tianitn333/QRS_FPGA_Code/docs/THIRD_PARTY.md

# 第三方来源

CAN控制器使用OpenCores CAN RTL，来源与版权见project/user_source/hdl_source/can/README.txt及各源文件头，保留LGPL相关声明；资源试验所固定上游提交为470f0e7ab174dfef01a05f5d5ad01f28f6f4dc17。

PLL、DDR、FIFO、MIPI/HDMI等包含安路及相关厂商生成或加密的IP源/元数据，保留原文件及版权头，需要匹配TD器件库/工具解释；本包不将第三方IP描述为参赛者原创，也不附工具安装包。源文件中的历史模块可作为依赖和完整源码保留，当前工程实际生效文件以AL为准，SD颜色持久化未在当前顶层启用。
