tianitn333/QRS_FPGA_Code/verification/board_success/README.md

# 用户成功段CAN记录核对

以CSV序号2074～3580为有效段，共1507条；2073只作为首个46请求的边界上下文。原始物理文件行号另存，避免表头偏移。原文件前2073条及诊断心跳不计作本次成功段。

共匹配746个完整请求/应答事务，包含3次双轴初始化、16条绝对位置命令（6条展示、10条零位），未见未配对应答或E2/EE拒绝。

| 请求序号 | 时间 | 地址 | 绝对目标 | 最后编码器 | 位置应答序号 | 最后状态 | 状态应答序号 |
| --- | --- | --- | ---: | ---: | --- | --- | --- |
| 2103 | 11:14:18:346 | 1 | 0 | 5 | 2109 | 3A 83 6B | 2111 |
| 2114 | 11:14:18:407 | 2 | 0 | -7 | 2120 | 3A 83 6B | 2122 |
| 2125 | 11:14:28:962 | 1 | -4047 | -82949 | 2313 | 3A 83 6B | 2315 |
| 2318 | 11:14:30:894 | 2 | -1727 | -35479 | 2420 | 3A 83 6B | 2422 |
| 2461 | 11:15:35:338 | 1 | 0 | -9 | 2467 | 3A 83 6B | 2469 |
| 2472 | 11:15:35:402 | 2 | 0 | -5 | 2478 | 3A 83 6B | 2480 |
| 2483 | 11:15:47:136 | 1 | -1727 | -35487 | 2621 | 3A 83 6B | 2623 |
| 2626 | 11:15:48:574 | 2 | -2817 | -57791 | 2818 | 3A 83 6B | 2820 |
| 2861 | 11:16:58:249 | 1 | 0 | -9 | 2867 | 3A 83 6B | 2869 |
| 2872 | 11:16:58:312 | 2 | 0 | -5 | 2878 | 3A 83 6B | 2880 |
| 2883 | 11:17:50:273 | 1 | 0 | -7 | 2889 | 3A 83 6B | 2891 |
| 2894 | 11:17:50:334 | 2 | 0 | -3 | 2900 | 3A 83 6B | 2902 |
| 2905 | 11:18:02:658 | 1 | -4047 | -82995 | 3143 | 3A 83 6B | 3145 |
| 3148 | 11:18:05:150 | 2 | -1727 | -35493 | 3282 | 3A 83 6B | 3284 |
| 3287 | 11:22:49:769 | 1 | 0 | 43 | 3473 | 3A 83 6B | 3475 |
| 3478 | 11:22:51:642 | 2 | 0 | -7 | 3578 | 3A 83 6B | 3580 |

所有位置命令均50RPM、绝对模式01、同步00；各次位置最终在对应±128计数容差内，随后状态为3A83。最后一次双轴回零请求序号3287/3478，编码器+43/-7，状态应答3475/3580。

主机时间戳大量重复，不能据此验证精确20ms等待或5ms分片间隔。记录中的FE/F3停止失能可能来自SW2操作等，不能仅凭这些命令认定FPGA故障。协议闭环通过不自动扩展成机械安全或长期稳定全部通过。
