tianitn333/QRS_FPGA_Code/verification/board_success/user_success_original.csv

序号 | 传输方向 | 时间标识-1 | 名称 | 帧ID(靠右对齐) | 帧格式 | 帧类型 | 数据长度 | 数据(HEX)
0 | 接收 | 10:05:37:834 |  | 0x00000100 | 数据帧 | 扩展帧 | 5 | 46 69 00 01 6B
1 | 接收 | 10:05:37:834 |  | 0x00000100 | 数据帧 | 扩展帧 | 3 | 46 02 6B
2 | 接收 | 10:05:37:834 |  | 0x00000100 | 数据帧 | 扩展帧 | 3 | 0A 6D 6B
3 | 接收 | 10:05:38:333 |  | 0x00000100 | 数据帧 | 扩展帧 | 4 | FE 98 00 6B
4 | 接收 | 10:05:38:333 |  | 0x00000100 | 数据帧 | 扩展帧 | 3 | FE 02 6B
5 | 接收 | 10:05:38:333 |  | 0x00000100 | 数据帧 | 扩展帧 | 5 | F3 AB 00 00 6B
6 | 接收 | 10:05:38:333 |  | 0x00000100 | 数据帧 | 扩展帧 | 3 | F3 02 6B
7 | 接收 | 10:05:38:333 |  | 0x00000200 | 数据帧 | 扩展帧 | 4 | FE 98 00 6B
8 | 接收 | 10:05:38:333 |  | 0x00000200 | 数据帧 | 扩展帧 | 3 | FE E2 6B
9 | 接收 | 10:05:38:333 |  | 0x00000200 | 数据帧 | 扩展帧 | 5 | F3 AB 00 00 6B
10 | 接收 | 10:05:38:333 |  | 0x00000200 | 数据帧 | 扩展帧 | 3 | F3 02 6B
11 | 接收 | 10:48:52:763 |  | 0x000007e0 | 数据帧 | 扩展帧 | 8 | 08 00 00 00 00 00 00 00
12 | 接收 | 10:48:52:763 |  | 0x000007e1 | 数据帧 | 扩展帧 | 8 | 00 00 00 00 00 00 00 00
13 | 接收 | 10:48:52:763 |  | 0x000007e0 | 数据帧 | 扩展帧 | 8 | 08 01 00 00 10 00 00 00
14 | 接收 | 10:48:52:763 |  | 0x000007e1 | 数据帧 | 扩展帧 | 8 | 00 00 00 00 00 00 00 00
15 | 接收 | 10:48:53:762 |  | 0x000007e0 | 数据帧 | 扩展帧 | 8 | 10 02 00 00 10 00 00 00
16 | 接收 | 10:48:53:762 |  | 0x000007e1 | 数据帧 | 扩展帧 | 8 | D7 00 00 00 00 00 00 00
17 | 接收 | 10:48:54:755 |  | 0x000007e0 | 数据帧 | 扩展帧 | 8 | 10 03 00 00 10 00 00 00
18 | 接收 | 10:48:54:755 |  | 0x000007e1 | 数据帧 | 扩展帧 | 8 | D7 00 00 00 00 00 00 00
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
1456 | 接收 | 11:00:53:764 |  | 0x000007e1 | 数据帧 | 扩展帧 | 8 | D7 00 00 00 00 00 00 00
1457 | 接收 | 11:00:54:766 |  | 0x000007e0 | 数据帧 | 扩展帧 | 8 | 10 D3 00 00 10 00 00 00
1458 | 接收 | 11:00:54:766 |  | 0x000007e1 | 数据帧 | 扩展帧 | 8 | D7 00 00 00 00 00 00 00
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
