tianitn333/QRS_FPGA_Code/project/user_source/hdl_source/anlogic_logo_palette.v

// Exact official Logo pixels: common colors plus tagged sparse read-only data.
// 官方Logo无损像素：常用色组合译码，其余颜色使用带标签的只读ERAM。
// One-clock read; the caller must present the previous pixel-stage address.
module anlogic_logo_palette (
    input wire clk,
    input wire rst_n,
    input wire [14:0] I_addr,
    output reg [24:0] O_pixel
);
    reg [11:0] displacement;
    wire [11:0] memory_address;
    wire [143:0] memory_data;
    wire [35:0] selected_data;
    reg [1:0] read_bank;
    reg [14:0] read_address;
    reg read_valid;
    reg [1:0] base_color;

    // The bucket and displacement retain all original address information.
    always @(*) begin
        displacement = 12'd0;
        case (I_addr[8:0])
            9'd0: displacement = 12'd335;
            9'd1: displacement = 12'd804;
            9'd2: displacement = 12'd832;
            9'd3: displacement = 12'd288;
            9'd4: displacement = 12'd834;
            9'd5: displacement = 12'd806;
            9'd6: displacement = 12'd840;
            9'd7: displacement = 12'd612;
            9'd8: displacement = 12'd851;
            9'd9: displacement = 12'd161;
            9'd10: displacement = 12'd842;
            9'd11: displacement = 12'd1361;
            9'd12: displacement = 12'd1648;
            9'd13: displacement = 12'd294;
            9'd14: displacement = 12'd620;
            9'd15: displacement = 12'd1664;
            9'd16: displacement = 12'd872;
            9'd17: displacement = 12'd866;
            9'd18: displacement = 12'd1442;
            9'd19: displacement = 12'd2209;
            9'd20: displacement = 12'd2364;
            9'd21: displacement = 12'd1665;
            9'd22: displacement = 12'd1342;
            9'd23: displacement = 12'd1336;
            9'd24: displacement = 12'd1317;
            9'd25: displacement = 12'd1666;
            9'd26: displacement = 12'd987;
            9'd27: displacement = 12'd785;
            9'd28: displacement = 12'd1586;
            9'd29: displacement = 12'd1672;
            9'd30: displacement = 12'd246;
            9'd31: displacement = 12'd1193;
            9'd32: displacement = 12'd932;
            9'd33: displacement = 12'd2067;
            9'd34: displacement = 12'd2368;
            9'd35: displacement = 12'd2369;
            9'd36: displacement = 12'd1572;
            9'd37: displacement = 12'd1717;
            9'd38: displacement = 12'd2370;
            9'd39: displacement = 12'd1667;
            9'd40: displacement = 12'd1142;
            9'd41: displacement = 12'd1043;
            9'd42: displacement = 12'd1201;
            9'd43: displacement = 12'd1255;
            9'd44: displacement = 12'd1697;
            9'd45: displacement = 12'd2371;
            9'd46: displacement = 12'd2036;
            9'd47: displacement = 12'd1398;
            9'd48: displacement = 12'd510;
            9'd49: displacement = 12'd2204;
            9'd50: displacement = 12'd2380;
            9'd51: displacement = 12'd1658;
            9'd52: displacement = 12'd1698;
            9'd53: displacement = 12'd1728;
            9'd54: displacement = 12'd896;
            9'd55: displacement = 12'd417;
            9'd56: displacement = 12'd751;
            9'd57: displacement = 12'd897;
            9'd58: displacement = 12'd2382;
            9'd59: displacement = 12'd1729;
            9'd60: displacement = 12'd308;
            9'd61: displacement = 12'd1534;
            9'd62: displacement = 12'd1713;
            9'd63: displacement = 12'd1730;
            9'd64: displacement = 12'd904;
            9'd65: displacement = 12'd928;
            9'd66: displacement = 12'd1678;
            9'd67: displacement = 12'd929;
            9'd68: displacement = 12'd320;
            9'd69: displacement = 12'd66;
            9'd70: displacement = 12'd938;
            9'd71: displacement = 12'd1731;
            9'd72: displacement = 12'd821;
            9'd73: displacement = 12'd34;
            9'd74: displacement = 12'd323;
            9'd75: displacement = 12'd917;
            9'd76: displacement = 12'd322;
            9'd77: displacement = 12'd352;
            9'd78: displacement = 12'd960;
            9'd79: displacement = 12'd1736;
            9'd80: displacement = 12'd961;
            9'd81: displacement = 12'd1737;
            9'd82: displacement = 12'd968;
            9'd83: displacement = 12'd969;
            9'd84: displacement = 12'd1761;
            9'd85: displacement = 12'd992;
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
            9'd510: displacement = 12'd781;
            9'd511: displacement = 12'd800;
            default: displacement = 12'd0;
        endcase
    end
    assign memory_address = displacement ^ {6'd0, I_addr[14:9]};
    assign selected_data = memory_data[read_bank*36 +: 36];

    // Match the synchronous ERAM port with its bucket tag and bank selection.
    always @(posedge clk or negedge rst_n) begin
        if (!rst_n) begin
            read_bank <= 2'd0;
            read_address <= 15'd0;
            read_valid <= 1'b0;
        end else begin
            read_bank <= memory_address[11:10];
            read_address <= I_addr;
            read_valid <= 1'b1;
        end
    end

    // Initialized 18x1024 word bank, read-only during video operation.
    PH1P_LOGIC_ERAM #(
        .DATA_WIDTH_A(18), .DATA_WIDTH_B(18), .ADDR_WIDTH_A(10), .ADDR_WIDTH_B(10),
        .DATA_DEPTH_A(1024), .DATA_DEPTH_B(1024), .MODE("DP"),
        .REGMODE_A("NOREG"), .REGMODE_B("NOREG"), .WRITEMODE_A("NORMAL"), .WRITEMODE_B("NORMAL"),
        .IMPLEMENT("20K(FAST)"), .ECC_ENCODE("DISABLE"), .ECC_DECODE("DISABLE"),
        .CLKMODE("ASYNC"), .SSROVERCE("DISABLE"), .OREGSET_A("RESET"), .OREGSET_B("RESET"),
        .RESETMODE_A("ASYNC"), .RESETMODE_B("ASYNC"),
        .ASYNC_RESET_RELEASE_A("ASYNC"), .ASYNC_RESET_RELEASE_B("ASYNC"),
        .INIT_FILE("logo_palette_data/bank_0_lane_0.dath"), .FILL_ALL("NONE")
    ) PH1P_LOGIC_ERAM_Inst_first_low (
        .dia(18'd0), .addra(10'd0), .cea(1'b0), .clka(clk), .wea(1'b0), .bea(1'b0), .rsta(1'b0), .ocea(1'b0),
        .dib(18'd0), .addrb(memory_address[9:0]), .ceb(1'b1), .clkb(clk), .web(1'b0), .beb(1'b0), .rstb(1'b0), .oceb(1'b0),
        .doa(), .dob(memory_data[17:0]),
        .ecc_sbiterr(), .ecc_dbiterr(), .ecc_sbiterrinj(1'b0), .ecc_dbiterrinj(1'b0)
    );

    // Initialized 18x1024 word bank, read-only during video operation.
    PH1P_LOGIC_ERAM #(
        .DATA_WIDTH_A(18), .DATA_WIDTH_B(18), .ADDR_WIDTH_A(10), .ADDR_WIDTH_B(10),
        .DATA_DEPTH_A(1024), .DATA_DEPTH_B(1024), .MODE("DP"),
        .REGMODE_A("NOREG"), .REGMODE_B("NOREG"), .WRITEMODE_A("NORMAL"), .WRITEMODE_B("NORMAL"),
        .IMPLEMENT("20K(FAST)"), .ECC_ENCODE("DISABLE"), .ECC_DECODE("DISABLE"),
        .CLKMODE("ASYNC"), .SSROVERCE("DISABLE"), .OREGSET_A("RESET"), .OREGSET_B("RESET"),
        .RESETMODE_A("ASYNC"), .RESETMODE_B("ASYNC"),
        .ASYNC_RESET_RELEASE_A("ASYNC"), .ASYNC_RESET_RELEASE_B("ASYNC"),
        .INIT_FILE("logo_palette_data/bank_0_lane_1.dath"), .FILL_ALL("NONE")
    ) PH1P_LOGIC_ERAM_Inst_first_high (
        .dia(18'd0), .addra(10'd0), .cea(1'b0), .clka(clk), .wea(1'b0), .bea(1'b0), .rsta(1'b0), .ocea(1'b0),
        .dib(18'd0), .addrb(memory_address[9:0]), .ceb(1'b1), .clkb(clk), .web(1'b0), .beb(1'b0), .rstb(1'b0), .oceb(1'b0),
        .doa(), .dob(memory_data[35:18]),
        .ecc_sbiterr(), .ecc_dbiterr(), .ecc_sbiterrinj(1'b0), .ecc_dbiterrinj(1'b0)
    );

    // Initialized 18x1024 word bank, read-only during video operation.
    PH1P_LOGIC_ERAM #(
        .DATA_WIDTH_A(18), .DATA_WIDTH_B(18), .ADDR_WIDTH_A(10), .ADDR_WIDTH_B(10),
        .DATA_DEPTH_A(1024), .DATA_DEPTH_B(1024), .MODE("DP"),
        .REGMODE_A("NOREG"), .REGMODE_B("NOREG"), .WRITEMODE_A("NORMAL"), .WRITEMODE_B("NORMAL"),
        .IMPLEMENT("20K(FAST)"), .ECC_ENCODE("DISABLE"), .ECC_DECODE("DISABLE"),
        .CLKMODE("ASYNC"), .SSROVERCE("DISABLE"), .OREGSET_A("RESET"), .OREGSET_B("RESET"),
        .RESETMODE_A("ASYNC"), .RESETMODE_B("ASYNC"),
        .ASYNC_RESET_RELEASE_A("ASYNC"), .ASYNC_RESET_RELEASE_B("ASYNC"),
        .INIT_FILE("logo_palette_data/bank_1_lane_0.dath"), .FILL_ALL("NONE")
    ) PH1P_LOGIC_ERAM_Inst_second_low (
        .dia(18'd0), .addra(10'd0), .cea(1'b0), .clka(clk), .wea(1'b0), .bea(1'b0), .rsta(1'b0), .ocea(1'b0),
        .dib(18'd0), .addrb(memory_address[9:0]), .ceb(1'b1), .clkb(clk), .web(1'b0), .beb(1'b0), .rstb(1'b0), .oceb(1'b0),
        .doa(), .dob(memory_data[53:36]),
        .ecc_sbiterr(), .ecc_dbiterr(), .ecc_sbiterrinj(1'b0), .ecc_dbiterrinj(1'b0)
    );

    // Initialized 18x1024 word bank, read-only during video operation.
    PH1P_LOGIC_ERAM #(
        .DATA_WIDTH_A(18), .DATA_WIDTH_B(18), .ADDR_WIDTH_A(10), .ADDR_WIDTH_B(10),
        .DATA_DEPTH_A(1024), .DATA_DEPTH_B(1024), .MODE("DP"),
        .REGMODE_A("NOREG"), .REGMODE_B("NOREG"), .WRITEMODE_A("NORMAL"), .WRITEMODE_B("NORMAL"),
        .IMPLEMENT("20K(FAST)"), .ECC_ENCODE("DISABLE"), .ECC_DECODE("DISABLE"),
        .CLKMODE("ASYNC"), .SSROVERCE("DISABLE"), .OREGSET_A("RESET"), .OREGSET_B("RESET"),
        .RESETMODE_A("ASYNC"), .RESETMODE_B("ASYNC"),
        .ASYNC_RESET_RELEASE_A("ASYNC"), .ASYNC_RESET_RELEASE_B("ASYNC"),
        .INIT_FILE("logo_palette_data/bank_1_lane_1.dath"), .FILL_ALL("NONE")
    ) PH1P_LOGIC_ERAM_Inst_second_high (
        .dia(18'd0), .addra(10'd0), .cea(1'b0), .clka(clk), .wea(1'b0), .bea(1'b0), .rsta(1'b0), .ocea(1'b0),
        .dib(18'd0), .addrb(memory_address[9:0]), .ceb(1'b1), .clkb(clk), .web(1'b0), .beb(1'b0), .rstb(1'b0), .oceb(1'b0),
        .doa(), .dob(memory_data[71:54]),
        .ecc_sbiterr(), .ecc_dbiterr(), .ecc_sbiterrinj(1'b0), .ecc_dbiterrinj(1'b0)
    );

    // Initialized 18x1024 word bank, read-only during video operation.
    PH1P_LOGIC_ERAM #(
        .DATA_WIDTH_A(18), .DATA_WIDTH_B(18), .ADDR_WIDTH_A(10), .ADDR_WIDTH_B(10),
        .DATA_DEPTH_A(1024), .DATA_DEPTH_B(1024), .MODE("DP"),
        .REGMODE_A("NOREG"), .REGMODE_B("NOREG"), .WRITEMODE_A("NORMAL"), .WRITEMODE_B("NORMAL"),
        .IMPLEMENT("20K(FAST)"), .ECC_ENCODE("DISABLE"), .ECC_DECODE("DISABLE"),
        .CLKMODE("ASYNC"), .SSROVERCE("DISABLE"), .OREGSET_A("RESET"), .OREGSET_B("RESET"),
        .RESETMODE_A("ASYNC"), .RESETMODE_B("ASYNC"),
        .ASYNC_RESET_RELEASE_A("ASYNC"), .ASYNC_RESET_RELEASE_B("ASYNC"),
        .INIT_FILE("logo_palette_data/bank_2_lane_0.dath"), .FILL_ALL("NONE")
    ) PH1P_LOGIC_ERAM_Inst_third_low (
        .dia(18'd0), .addra(10'd0), .cea(1'b0), .clka(clk), .wea(1'b0), .bea(1'b0), .rsta(1'b0), .ocea(1'b0),
        .dib(18'd0), .addrb(memory_address[9:0]), .ceb(1'b1), .clkb(clk), .web(1'b0), .beb(1'b0), .rstb(1'b0), .oceb(1'b0),
        .doa(), .dob(memory_data[89:72]),
        .ecc_sbiterr(), .ecc_dbiterr(), .ecc_sbiterrinj(1'b0), .ecc_dbiterrinj(1'b0)
    );

    // Initialized 18x1024 word bank, read-only during video operation.
    PH1P_LOGIC_ERAM #(
        .DATA_WIDTH_A(18), .DATA_WIDTH_B(18), .ADDR_WIDTH_A(10), .ADDR_WIDTH_B(10),
        .DATA_DEPTH_A(1024), .DATA_DEPTH_B(1024), .MODE("DP"),
        .REGMODE_A("NOREG"), .REGMODE_B("NOREG"), .WRITEMODE_A("NORMAL"), .WRITEMODE_B("NORMAL"),
        .IMPLEMENT("20K(FAST)"), .ECC_ENCODE("DISABLE"), .ECC_DECODE("DISABLE"),
        .CLKMODE("ASYNC"), .SSROVERCE("DISABLE"), .OREGSET_A("RESET"), .OREGSET_B("RESET"),
        .RESETMODE_A("ASYNC"), .RESETMODE_B("ASYNC"),
        .ASYNC_RESET_RELEASE_A("ASYNC"), .ASYNC_RESET_RELEASE_B("ASYNC"),
        .INIT_FILE("logo_palette_data/bank_2_lane_1.dath"), .FILL_ALL("NONE")
    ) PH1P_LOGIC_ERAM_Inst_third_high (
        .dia(18'd0), .addra(10'd0), .cea(1'b0), .clka(clk), .wea(1'b0), .bea(1'b0), .rsta(1'b0), .ocea(1'b0),
        .dib(18'd0), .addrb(memory_address[9:0]), .ceb(1'b1), .clkb(clk), .web(1'b0), .beb(1'b0), .rstb(1'b0), .oceb(1'b0),
        .doa(), .dob(memory_data[107:90]),
        .ecc_sbiterr(), .ecc_dbiterr(), .ecc_sbiterrinj(1'b0), .ecc_dbiterrinj(1'b0)
    );

    // The fourth logical bank is entirely zero in the immutable pixel model.
    // Keep its logical capacity and value without allocating physical ERAM.
    assign memory_data[143:108] = 36'd0;

    // Two frequent colors use a small exact address decoder.
    always @(*) begin
        base_color = 2'd0;
        case (read_address)
            15'd5974, 15'd6134, 15'd6293, 15'd6294, 15'd6295, 15'd6453, 15'd6454, 15'd6455, 15'd6612, 15'd6613, 15'd6614, 15'd6615, 15'd6616, 15'd6772, 15'd6773, 15'd6774, 15'd6775, 15'd6776, 15'd6931, 15'd6932, 15'd6933, 15'd6934, 15'd6935, 15'd6936, 15'd6937, 15'd7091, 15'd7092, 15'd7093, 15'd7094, 15'd7095, 15'd7096, 15'd7097, 15'd7250, 15'd7251, 15'd7252, 15'd7253, 15'd7254, 15'd7255, 15'd7256, 15'd7257, 15'd7258, 15'd7410, 15'd7411, 15'd7412, 15'd7413, 15'd7414, 15'd7415, 15'd7416, 15'd7417, 15'd7418, 15'd7569, 15'd7570, 15'd7571, 15'd7572, 15'd7573, 15'd7574, 15'd7575, 15'd7576, 15'd7577, 15'd7578, 15'd7579, 15'd7729, 15'd7730, 15'd7731, 15'd7732, 15'd7733, 15'd7734, 15'd7735, 15'd7736, 15'd7737, 15'd7738, 15'd7739, 15'd7888, 15'd7889, 15'd7890, 15'd7891, 15'd7892, 15'd7893, 15'd7894, 15'd7895, 15'd7896, 15'd7897, 15'd7898, 15'd7899, 15'd7900, 15'd8048, 15'd8049, 15'd8050, 15'd8051, 15'd8052, 15'd8053, 15'd8054, 15'd8055, 15'd8056, 15'd8057, 15'd8058, 15'd8059, 15'd8060, 15'd8207, 15'd8208, 15'd8209, 15'd8210, 15'd8211, 15'd8212, 15'd8213, 15'd8214, 15'd8215, 15'd8216, 15'd8217, 15'd8218, 15'd8219, 15'd8220, 15'd8221, 15'd8367, 15'd8368, 15'd8369, 15'd8370, 15'd8371, 15'd8372, 15'd8373, 15'd8374, 15'd8375, 15'd8376, 15'd8377, 15'd8378, 15'd8379, 15'd8380, 15'd8381, 15'd8526, 15'd8527, 15'd8528, 15'd8529, 15'd8530, 15'd8531, 15'd8532, 15'd8533, 15'd8534, 15'd8535, 15'd8536, 15'd8537, 15'd8538, 15'd8539, 15'd8540, 15'd8541, 15'd8542, 15'd8686, 15'd8687, 15'd8688, 15'd8689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
            default: O_pixel = 25'd0;
        endcase
        if (selected_data[33] && selected_data[32:24] == read_address[8:0]) begin
            O_pixel = {1'b1, selected_data[23:0]};
        end
        if (!read_valid) begin
            O_pixel = 25'd0;
        end
    end
endmodule
