tianitn333/QRS_FPGA_Code/project/user_source/hdl_source/anlogic_logo_rom.v

// Source: official HX1P35A_Contest_202606 Lab 3 OSD example; copied without logic changes.
module anlogic_logo_rom (
    input wire [14:0] I_addr,
    output reg [24:0] O_pixel
);

    always @(*) begin
        case(I_addr)
            15'd5494: O_pixel = 25'h1d3d4d8;
            15'd5499: O_pixel = 25'h1fcd5d5;
            15'd5500: O_pixel = 25'h1f88688;
            15'd5501: O_pixel = 25'h1f77e81;
            15'd5502: O_pixel = 25'h1f77e81;
            15'd5503: O_pixel = 25'h1f77e81;
            15'd5504: O_pixel = 25'h1f77e81;
            15'd5505: O_pixel = 25'h1f77e81;
            15'd5506: O_pixel = 25'h1f77e81;
            15'd5507: O_pixel = 25'h1f77e81;
            15'd5508: O_pixel = 25'h1f77e81;
            15'd5509: O_pixel = 25'h1f77e81;
            15'd5510: O_pixel = 25'h1f77e81;
            15'd5511: O_pixel = 25'h1f77e81;
            15'd5512: O_pixel = 25'h1f77e81;
            15'd5513: O_pixel = 25'h1f77e81;
            15'd5514: O_pixel = 25'h1f77e81;
            15'd5515: O_pixel = 25'h1f77e81;
            15'd5516: O_pixel = 25'h1f77e81;
            15'd5517: O_pixel = 25'h1f77e81;
            15'd5518: O_pixel = 25'h1f77e81;
            15'd5519: O_pixel = 25'h1f77e81;
            15'd5520: O_pixel = 25'h1f77e81;
            15'd5521: O_pixel = 25'h1f77e81;
            15'd5522: O_pixel = 25'h1f77e81;
            15'd5523: O_pixel = 25'h1f77e81;
            15'd5524: O_pixel = 25'h1f77e81;
            15'd5525: O_pixel = 25'h1f77e81;
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
            15'd11723: O_pixel = 25'h11c2d4e;
            15'd11724: O_pixel = 25'h11c2d4e;
            15'd11725: O_pixel = 25'h11c2d4e;
            15'd11726: O_pixel = 25'h11c2d4e;
            15'd11727: O_pixel = 25'h11c2d4e;
            15'd11728: O_pixel = 25'h11c2d4e;
            15'd11729: O_pixel = 25'h11c2d4e;
            15'd11730: O_pixel = 25'h11c2d4e;
            15'd11731: O_pixel = 25'h11c2d4e;
            15'd11732: O_pixel = 25'h11c2d4e;
            15'd11733: O_pixel = 25'h11c2d4e;
            15'd11734: O_pixel = 25'h11c2d4e;
            15'd11735: O_pixel = 25'h11c2d4e;
            15'd11736: O_pixel = 25'h11c2d4e;
            15'd11737: O_pixel = 25'h11c2d4e;
            15'd11738: O_pixel = 25'h11c2d4e;
            15'd11739: O_pixel = 25'h11c2d4e;
            15'd11740: O_pixel = 25'h11c2d4e;
            15'd11741: O_pixel = 25'h11c2d4e;
            15'd11742: O_pixel = 25'h11c2d4e;
            15'd11743: O_pixel = 25'h11c2d4e;
            15'd11744: O_pixel = 25'h11c2d4e;
            15'd11745: O_pixel = 25'h11c2d4e;
            15'd11746: O_pixel = 25'h11c2d4e;
            15'd11747: O_pixel = 25'h11c2d4e;
            15'd11748: O_pixel = 25'h11c2d4e;
            15'd11749: O_pixel = 25'h11c2d4e;
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
