tianitn333/QRS_FPGA_Code/(commit log)

2026-11-04 基于FPGA的实时视觉感知系统：完整源码、bit、验证记录与文档
    [.m_params_MCU.txt, .m_params_PLL.txt, .m_params_blk_mem_gen_awb_delay_signal.txt, .m_params_blk_mem_gen_demosaic.txt, .m_params_blk_mem_gen_zhenghe.txt, .m_params_ddr2.txt, .m_params_w128_d512_fifo.txt, .m_params_w155_d512_fifo.txt]
2026-11-05 添加一镜到底演示视频与封面，README 置顶展示
