tianitn333/QRS_FPGA_Code/(notices)

Notices in the files:
project/user_source/hdl_source/can/can_registers.v:
Copyright (C) 2002, 2003 Authors
Public License as published by the Free Software Foundation;
Public License along with this source; if not, download it
from http://www.opencores.org/lgpl.shtml
project/user_source/hdl_source/can/can_top.v:
Copyright (C) 2002, 2003, 2004 Authors
